MM-X/dirtybot/3D model/model3.jpg

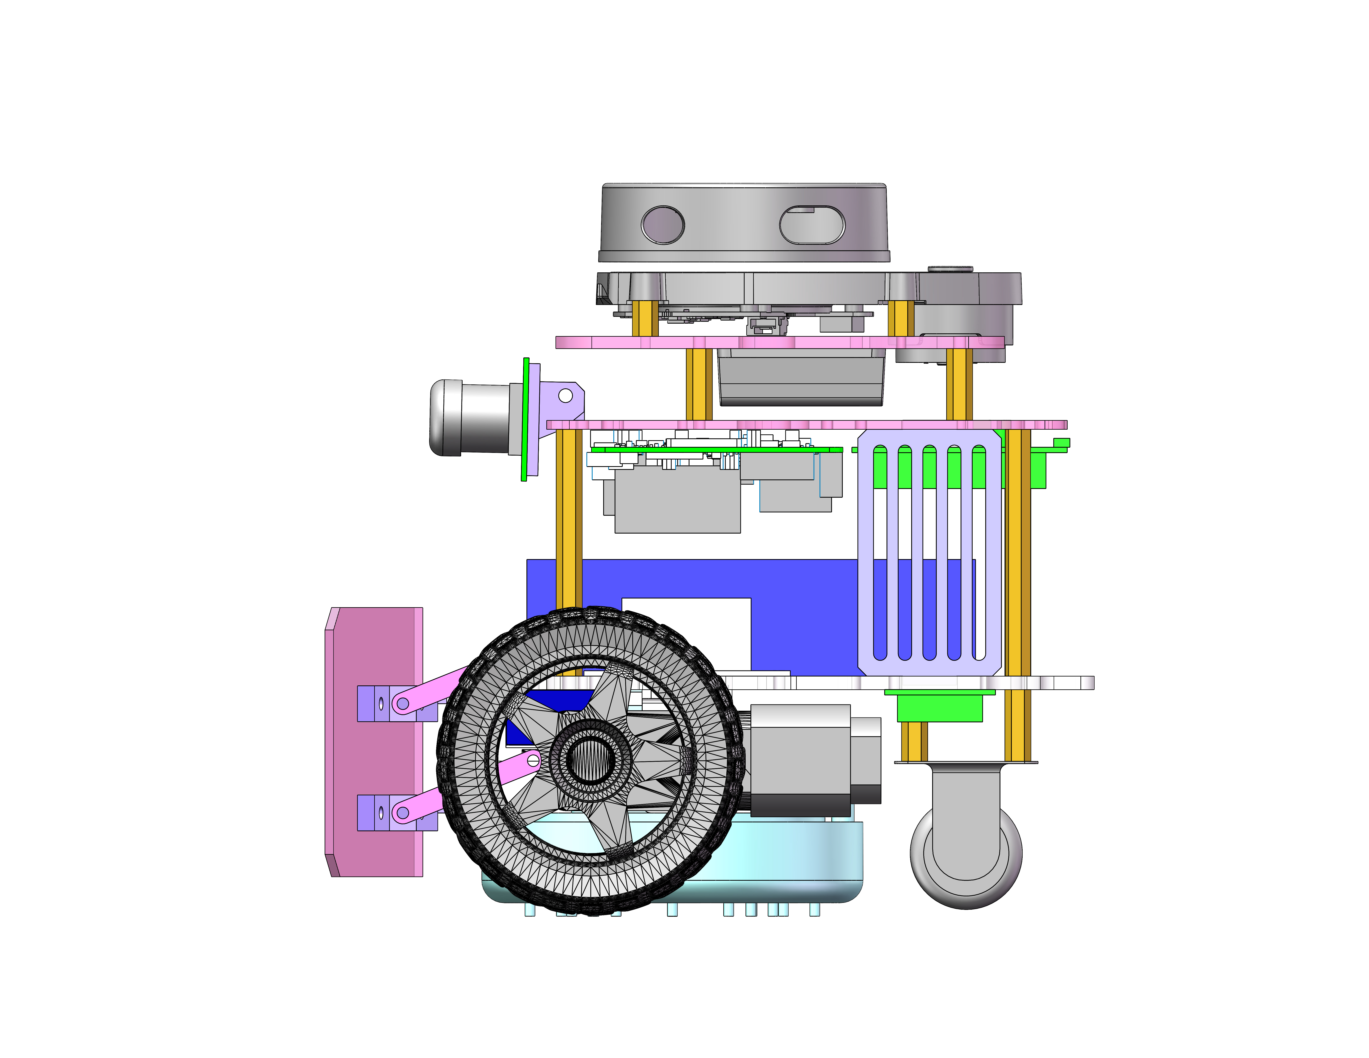
3D model/model3.jpg
