MM-X/dirtybot/docs/car/1.jpg

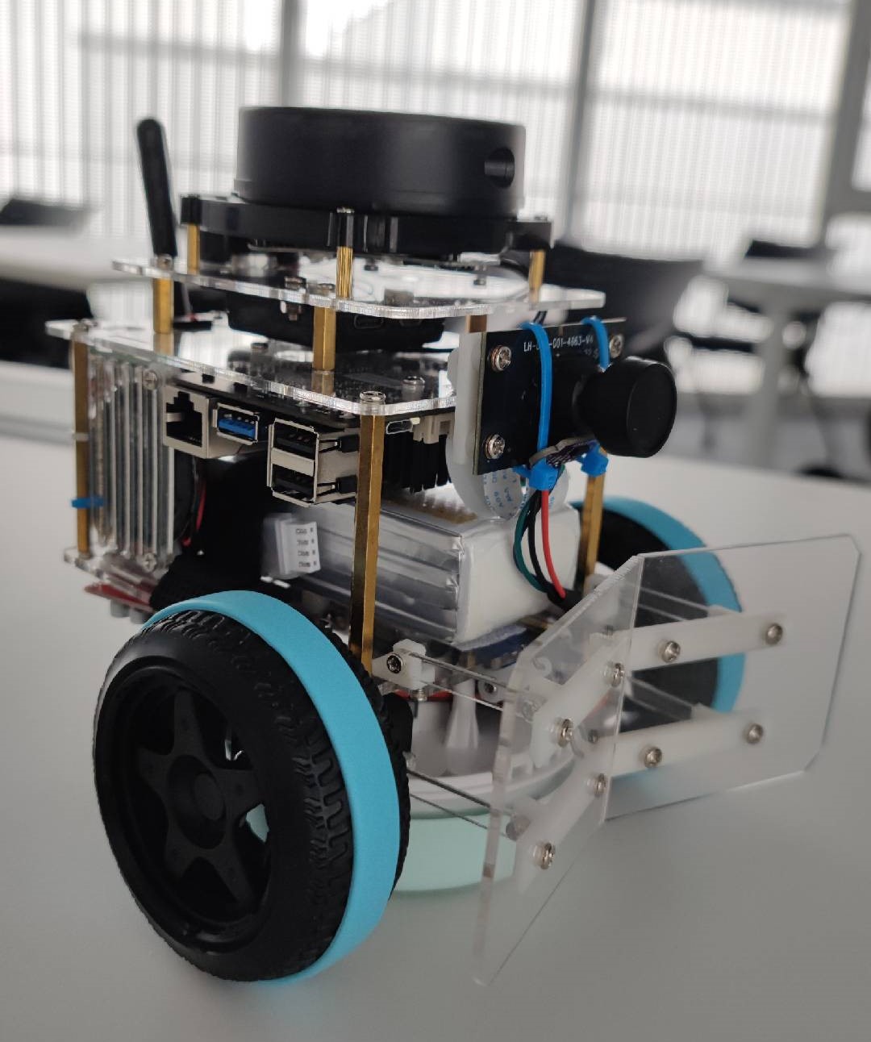
docs/car/1.jpg
