MM-X/dirtybot/docs/car/2.jpg

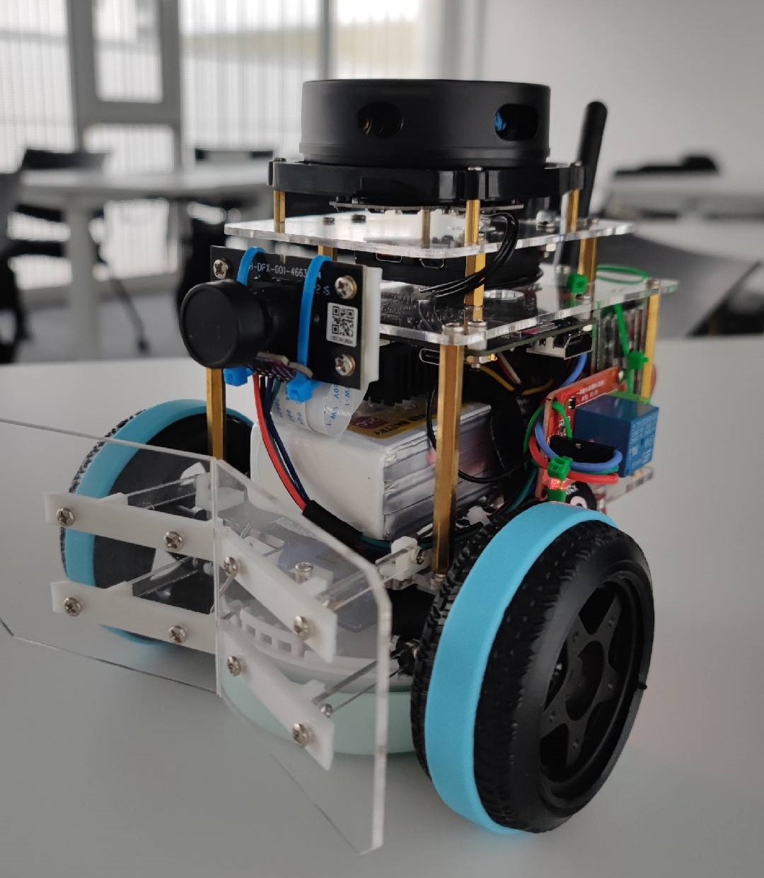
docs/car/2.jpg
