MM-X/dirtybot/docs/car/5.jpg

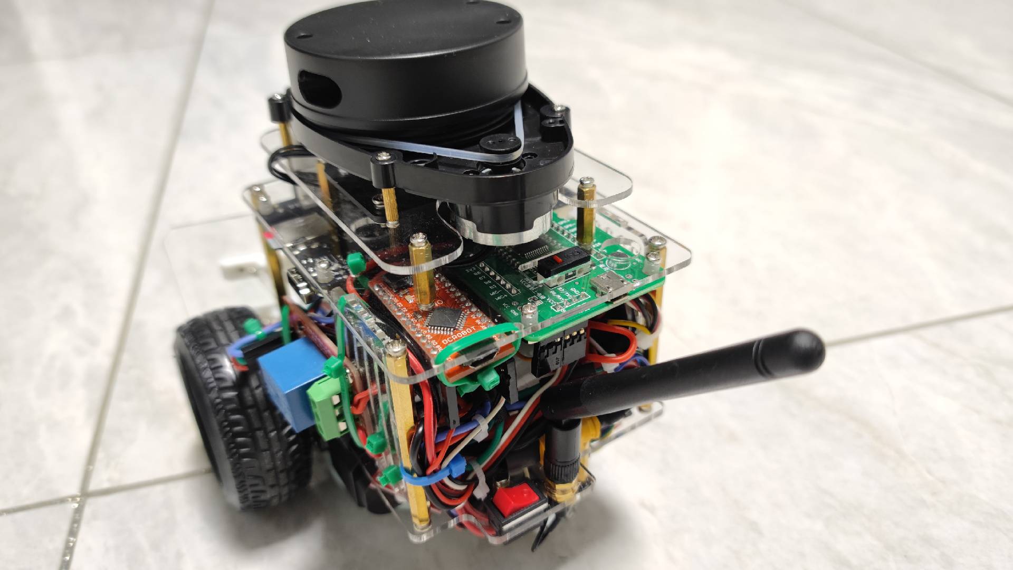
docs/car/5.jpg
