MM-X/dirtybot/docs/car/6.jpg

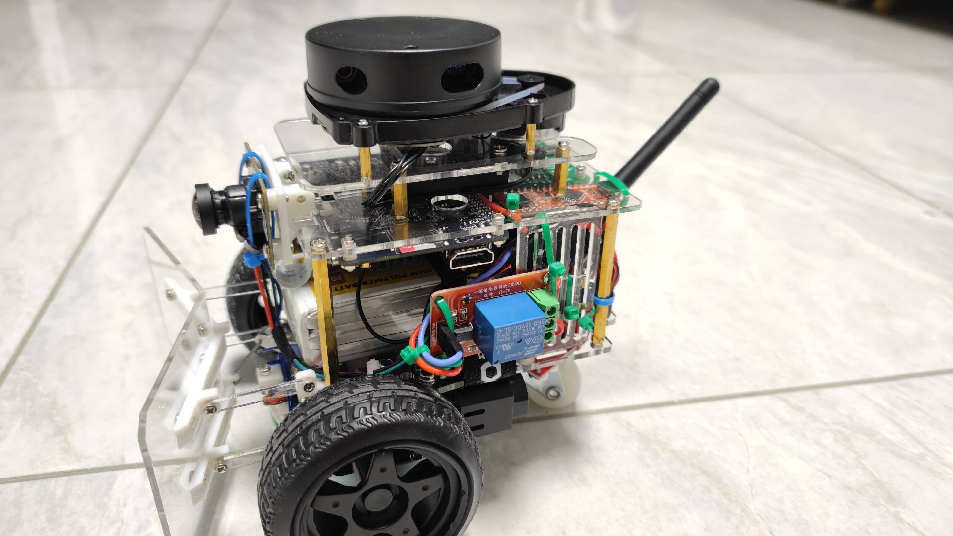
docs/car/6.jpg
