MM-X/dirtybot/docs/car/7.jpg

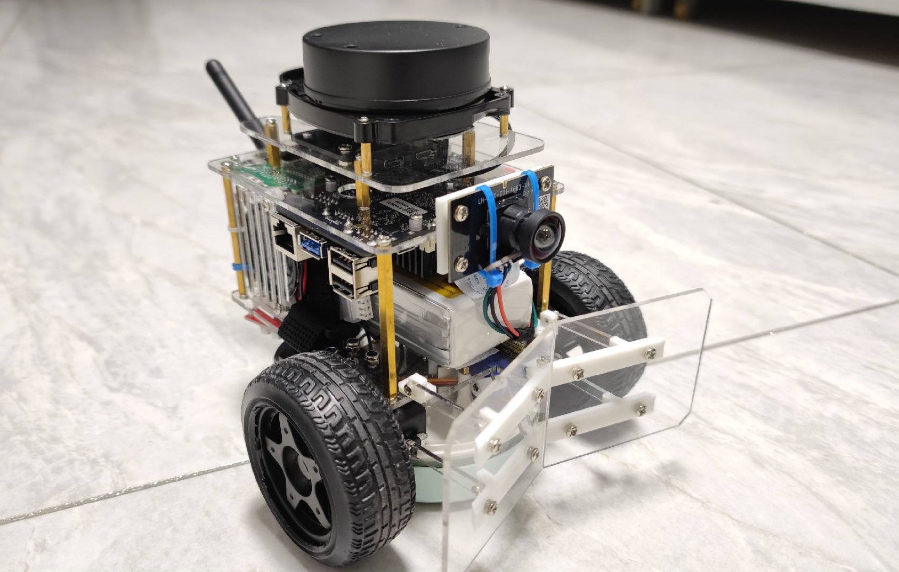
docs/car/7.jpg
