MM-X/dirtybot/Arduino/dirtybot/eeprom_utils.h

#include "MPU9250.h"          // MPU9250
#include <EEPROM.h>

// PID param  P = 51   I=53   D=55
const uint8_t EEPROM_SIZE = 1 + sizeof(float) * 3 * 4;
extern MPU9250 mpu;
extern volatile int kp;
extern volatile int ki;
extern volatile int kd;

enum EEP_ADDR {
    EEP_CALIB_FLAG = 0x00,
    EEP_ACC_BIAS = 0x01,
    EEP_GYRO_BIAS = 0x0D,
    EEP_MAG_BIAS = 0x19,
    EEP_MAG_SCALE = 0x25
};

void writeByte(int address, byte value) {
    EEPROM.put(address, value);
}

void writeFloat(int address, float value) {
    EEPROM.put(address, value);
}

void writeInt(int address, int value) {
    EEPROM.put(address, value);
}

byte readByte(int address) {
    byte valueIn = 0;
    EEPROM.get(address, valueIn);
    return valueIn;
}

int readInt(int address) {
    int valueIn = 0;
    EEPROM.get(address, valueIn);
    return valueIn;
}

float readFloat(int address) {
    float valueIn = 0;
    EEPROM.get(address, valueIn);
    return valueIn;
}

void clearCalibration() {
    writeByte(EEP_CALIB_FLAG, 0);
}

bool isCalibrated() {
    return (readByte(EEP_CALIB_FLAG) == 0x01);
}

void loadCalibration() {
    // Serial.println("Load calibrated parameters from EEPROM");
    // if (isCalibrated()) {
        // Serial.println("calibrated? : YES");
        // Serial.println("load calibrated values");
        mpu.setAccBias(
            readFloat(EEP_ACC_BIAS + 0),
            readFloat(EEP_ACC_BIAS + 4),
            readFloat(EEP_ACC_BIAS + 8));
        mpu.setGyroBias(
            readFloat(EEP_GYRO_BIAS + 0),
            readFloat(EEP_GYRO_BIAS + 4),
            readFloat(EEP_GYRO_BIAS + 8));
        mpu.setMagBias(
            readFloat(EEP_MAG_BIAS + 0),
            readFloat(EEP_MAG_BIAS + 4),
            readFloat(EEP_MAG_BIAS + 8));
        mpu.setMagScale(
            readFloat(EEP_MAG_SCALE + 0),
            readFloat(EEP_MAG_SCALE + 4),
            readFloat(EEP_MAG_SCALE + 8));
    // } else {
        // Serial.println("calibrated? : NO");
        // Serial.println("load default values");
    //     mpu.setAccBias(0., 0., 0.);
    //     mpu.setGyroBias(0., 0., 0.);
    //     mpu.setMagBias(0., 0., 0.);
    //     mpu.setMagScale(1., 1., 1.);
    // }
}

void savePidParam() {
  writeInt(51, kp);
  writeInt(53, ki);
  writeInt(55, kd);
}

void readPidParam() {
  kp = readInt(51);
  ki = readInt(53);
  kd = readInt(55);
}
