MM-X/dirtybot/(commit log)

2022-11-05 Add mpu9250 calibration program and yaw closed-loop control
2022-11-14 Add imu yaw to odom
